StudioKAT/SRSH/v1.0/Images/SRSH_v1.0_Back.jpg

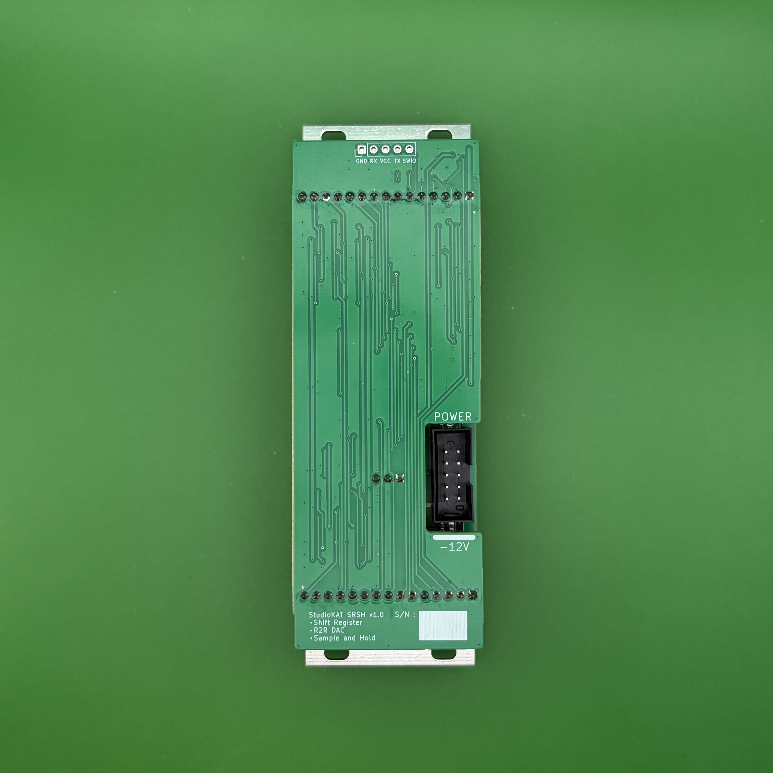
v1.0/Images/SRSH_v1.0_Back.jpg
