StudioKAT/SRSH/v1.0/Images/SRSH_v1.0_Side.jpg

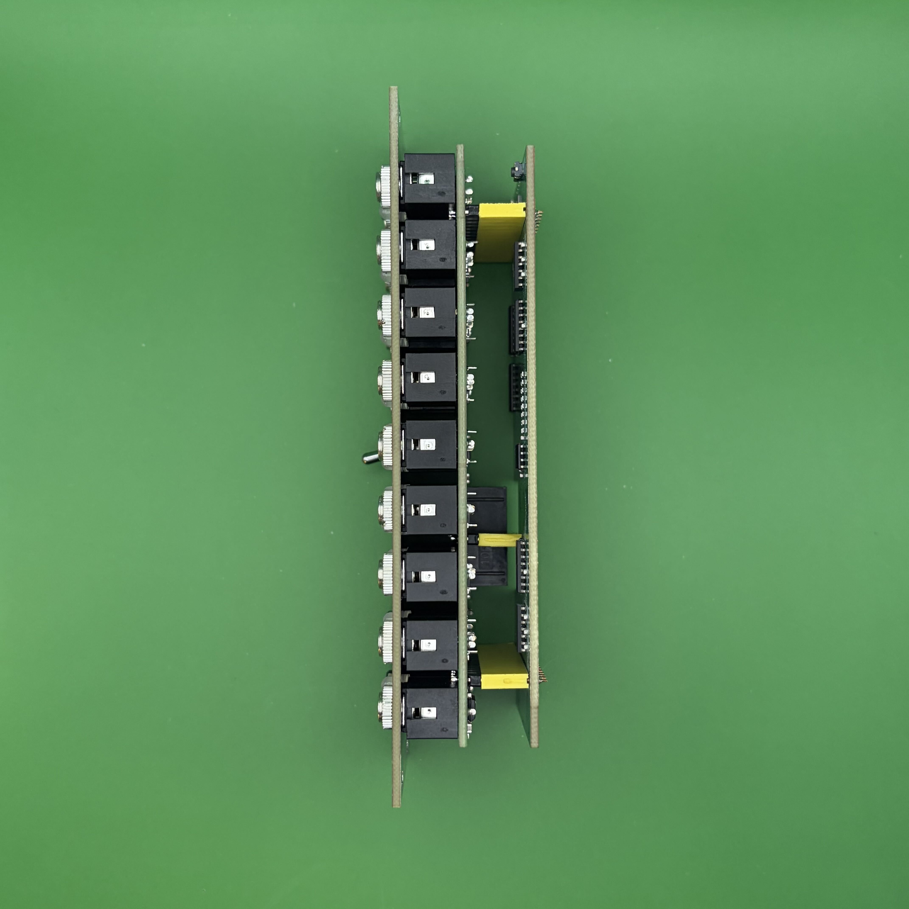
v1.0/Images/SRSH_v1.0_Side.jpg
