StudioKAT/SRSH/v1.0/Gerber_for_JLCPCB/Main_A/bom.csv

Designator | Footprint | Quantity | Value | LCSC Part #
C12, C13, C20, C21, C26, C27, C5, C6 | 0603 | 8 | 100nF | C14663
C25 | 0603 | 1 | 330nF | C1615
C28 | 0603 | 1 | 1uF | C15849
C29 | 0603 | 1 | 10pF | C1634
C3, C4 | 0805 | 2 | 22uF | C45783
D1, D2 | D_SOD-323 | 2 | 1N5819WS | C191023
D10, D11, D12, D13, D14, D15, D16, D8, D9 | LED_D3.0mm_2hp | 9 | LED
D17, D18, D19, D20, D21, D22, D23, D24 | LED_D3.0mm_2hp | 8 | LED_Dual_Bidirectional
D3, D4, D5, D6 | D_SOD-323 | 4 | 1N4148WS | C2128
J1 | BoxHeader_2x05_2.54mm_Europower | 1 | POWER
J10 | AudioJack_PJ301M-12 | 1 | RESET_IN
J11 | AudioJack_PJ301M-12 | 1 | DATA_IN
J12 | AudioJack_PJ301M-12 | 1 | XOR_IN
J13 | AudioJack_PJ301M-12 | 1 | R2R_OUT
J14 | AudioJack_PJ301M-12 | 1 | GATE_OUT_1
J15 | AudioJack_PJ301M-12 | 1 | GATE_OUT_2
J16 | AudioJack_PJ301M-12 | 1 | GATE_OUT_3
J17 | AudioJack_PJ301M-12 | 1 | GATE_OUT_4
J18 | AudioJack_PJ301M-12 | 1 | GATE_OUT_5
J19 | AudioJack_PJ301M-12 | 1 | GATE_OUT_6
J2, J5 | PinHeader_1x15_P2.54mm_Vertical | 2 | Conn_01x15_Pin
J20 | AudioJack_PJ301M-12 | 1 | GATE_OUT_7
J21 | AudioJack_PJ301M-12 | 1 | GATE_OUT_8
J22 | AudioJack_PJ301M-12 | 1 | SOURCE
J23 | AudioJack_PJ301M-12 | 1 | S&H_OUT_1
J24 | AudioJack_PJ301M-12 | 1 | S&H_OUT_2
J25 | AudioJack_PJ301M-12 | 1 | S&H_OUT_3
J26 | AudioJack_PJ301M-12 | 1 | S&H_OUT_4
J27 | AudioJack_PJ301M-12 | 1 | S&H_OUT_5
J28 | AudioJack_PJ301M-12 | 1 | S&H_OUT_6
J29 | AudioJack_PJ301M-12 | 1 | S&H_OUT_7
J30 | AudioJack_PJ301M-12 | 1 | S&H_OUT_8
J7 | PinHeader_1x03_P2.54mm_Vertical | 1 | Conn_01x03_Pin
J9 | AudioJack_PJ301M-12 | 1 | CLOCK_IN
Q1, Q2 | SOT-23 | 2 | MMBT3904 | C20526
Q10, Q11, Q12, Q13, Q14, Q15, Q4, Q5, Q6, Q7, Q8, Q9 | SOT-23 | 12 | BC847B | C20069135
R10, R11, R12, R33, R34, R35, R36, R37, R46, R47, R48, R49, R59, R60, R61, R62, R63, R64, R65, R66 | 0603 | 20 | 10k | C25804
R13, R43 | 0603 | 2 | 1M | C22935
R22 | 0603 | 1 | 2.2M | C22938
R31 | 0603 | 1 | 4.7k | C23162
R32, R39, R40, R41, R42 | 0603 | 5 | 100k | C25803
R44, R51, R52, R53, R54, R55, R56, R57, R58, R67, R68, R69, R70, R71, R72, R73, R74, R75, R77, R79, R81, R83, R85, R87, R89 | 0603 | 25 | 1k | C21190
R50 | 0603 | 1 | 100 | C22775
R76, R78, R80, R82, R84, R86, R88, R90 | 0603 | 8 | 2.2k | C4190
SW2 | ToggleSwitch_2MS1-T2-B4-M2-Q-E-S | 1 | SW_SPDT
SW3, SW4 | SW_PUSH_6mm_H13mm | 2 | SW_Push
U10 | SOT-89-3 | 1 | 78L05G-AB3-R | C71136
U3 | SOIC-8_3.9x4.9mm_P1.27mm | 1 | TL072CDT | C6961
