StudioKAT/SRSH/v1.0/Gerber_for_JLCPCB/Main_B/bom.csv

Designator | Footprint | Quantity | Value | LCSC Part #
C1, C10, C11, C14, C15, C16, C17, C18, C19, C2, C22, C23, C24, C7, C8, C9 | 0603 | 16 | 100nF | C14663
C30, C31, C32, C33, C34, C35, C36, C37 | 0603 | 8 | 10nF | C57112
D7 | D_SOD-323 | 1 | 1N4148WS | C2128
J3, J6 | PinSocket_1x15_P2.54mm_Vertical | 2 | Conn_01x15_Socket
J4 | PinHeader_1x05_P2.54mm_Vertical | 1 | EXT_Pinouts
J8 | PinSocket_1x03_P2.54mm_Vertical | 1 | Conn_01x03_Socket
Q3 | SOT-23 | 1 | BC847B | C20069135
R1, R2, R3, R4, R7 | 0603 | 5 | 100 | C22775
R14, R15, R16, R17, R18, R19, R20, R21, R30 | 0603 | 9 | 30k | C22984
R23, R24, R25, R26, R27, R28, R29 | 0603 | 7 | 15k | C22809
R38, R5, R6 | 0603 | 3 | 10k | C25804
R45, R8, R9 | 0603 | 3 | 1k | C21190
SW1 | SW_Push_TS-1088-AR02016 | 1 | TS-1088-AR02016 | C720477
U1, U2 | SOIC-14_3.9x8.7mm_P1.27mm | 2 | TL074IDR | C6964
U4 | SOIC-8_3.9x4.9mm_P1.27mm | 1 | TL072CDT | C6961
U5 | QFN-20-1EP_3x3mm_P0.4mm_EP1.65x1.65mm | 1 | CH32V003F4U6 | C5299908
U6, U7 | SOIC-16_3.9x9.9mm_P1.27mm | 2 | 74HC595D | C5947
U8, U9 | SOIC-16_3.9x9.9mm_P1.27mm | 2 | DG411DY-T1-E3 | C17218
