StudioKAT/SRSH/v1.0/Schematics/SRSH_v1.0_schematics.pdf

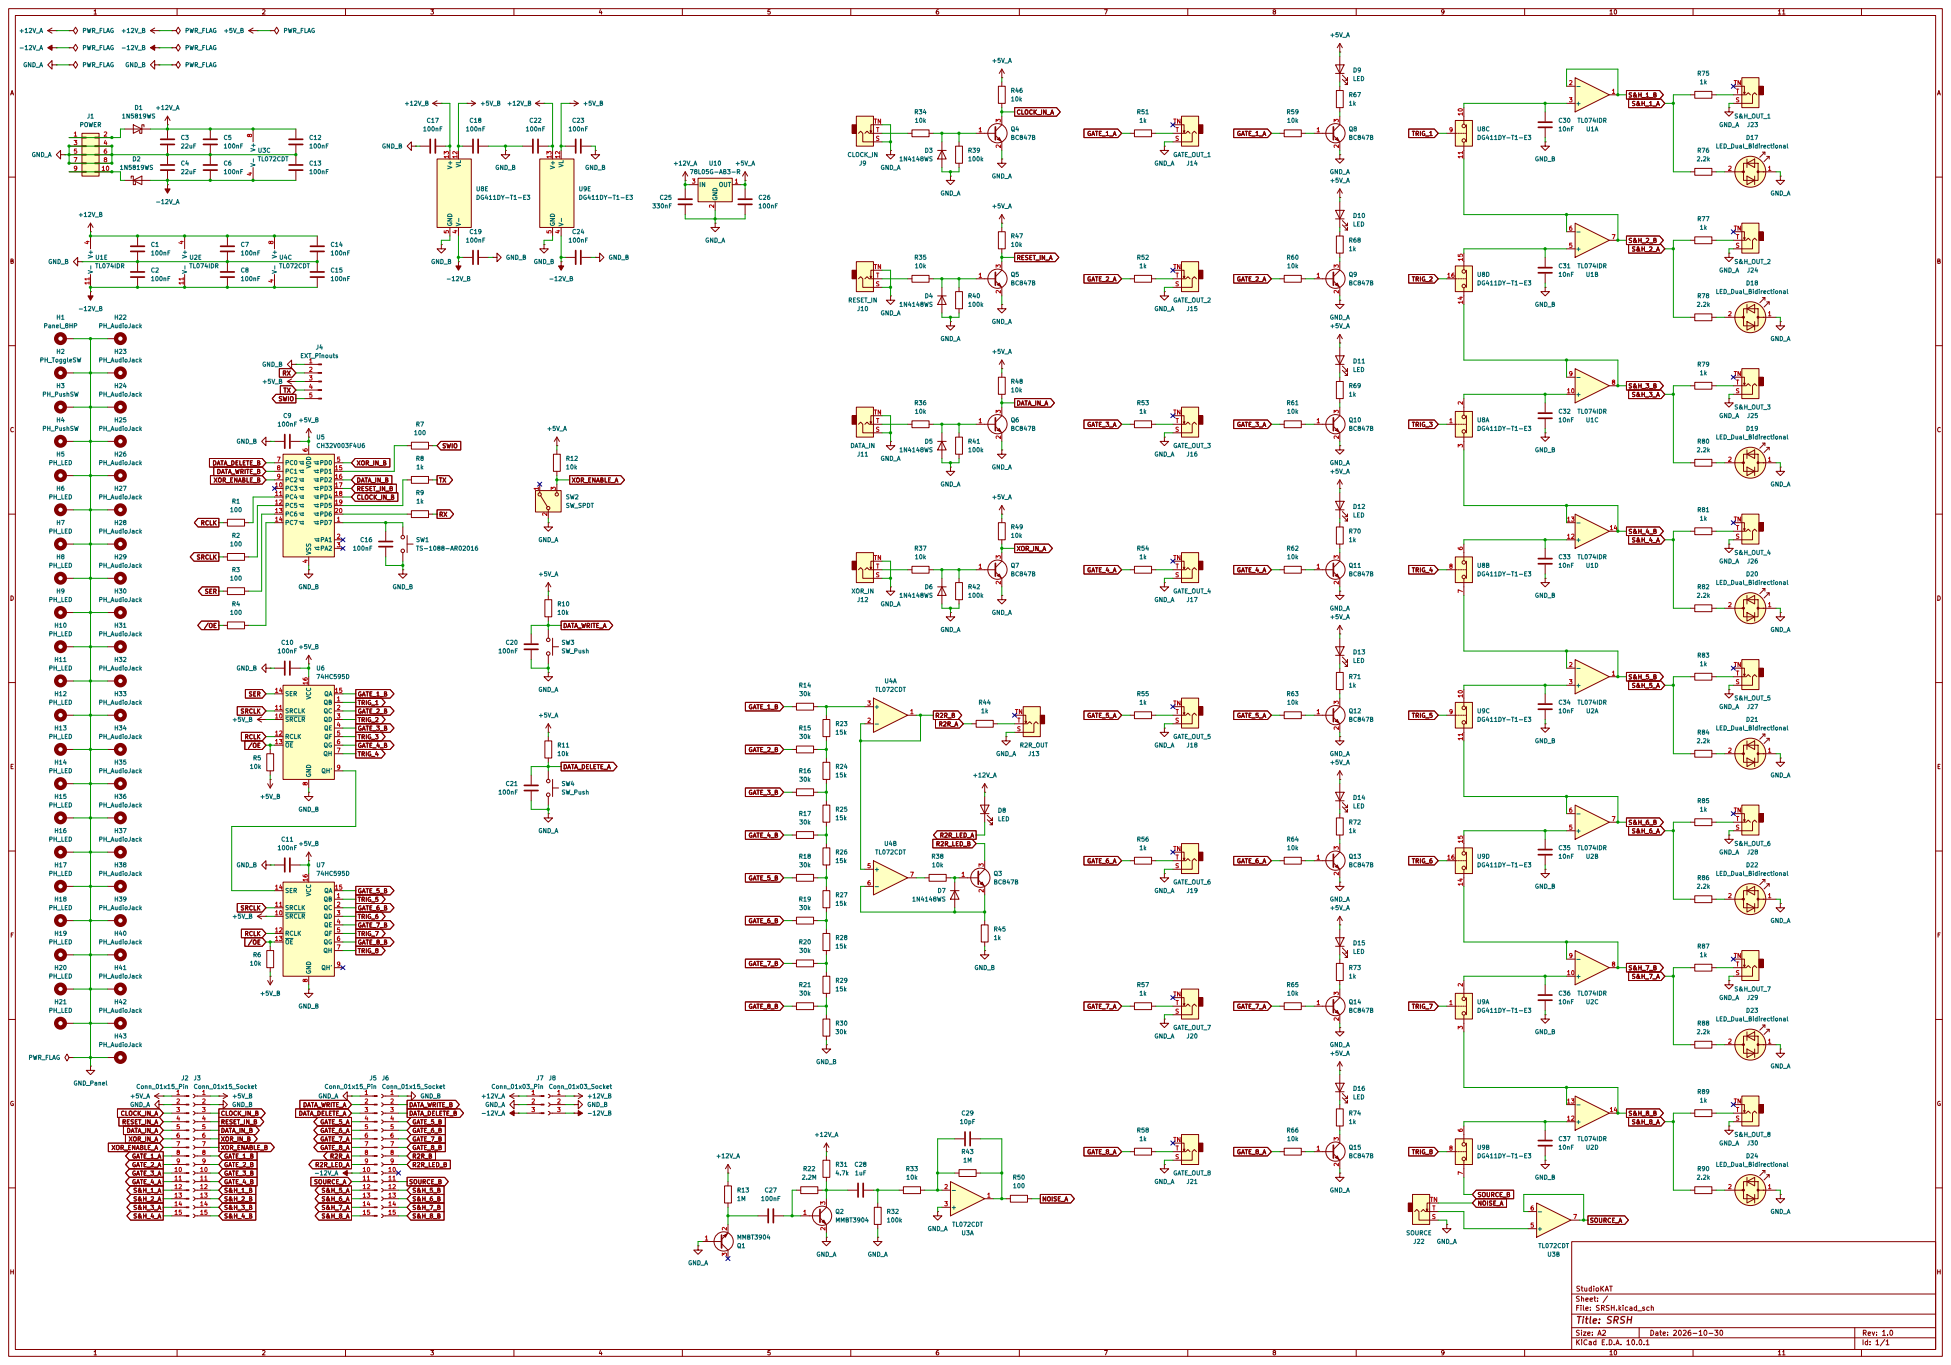
[picture p5: page 1]
