StudioKAT/SRSH/v1.0/KiCAD/SRSH_v1.0/SRSH_v1.0.kicad_pcb

## KiCad design v1.0/KiCAD/SRSH_v1.0/SRSH_v1.0.kicad_pcb (2026-10-30)

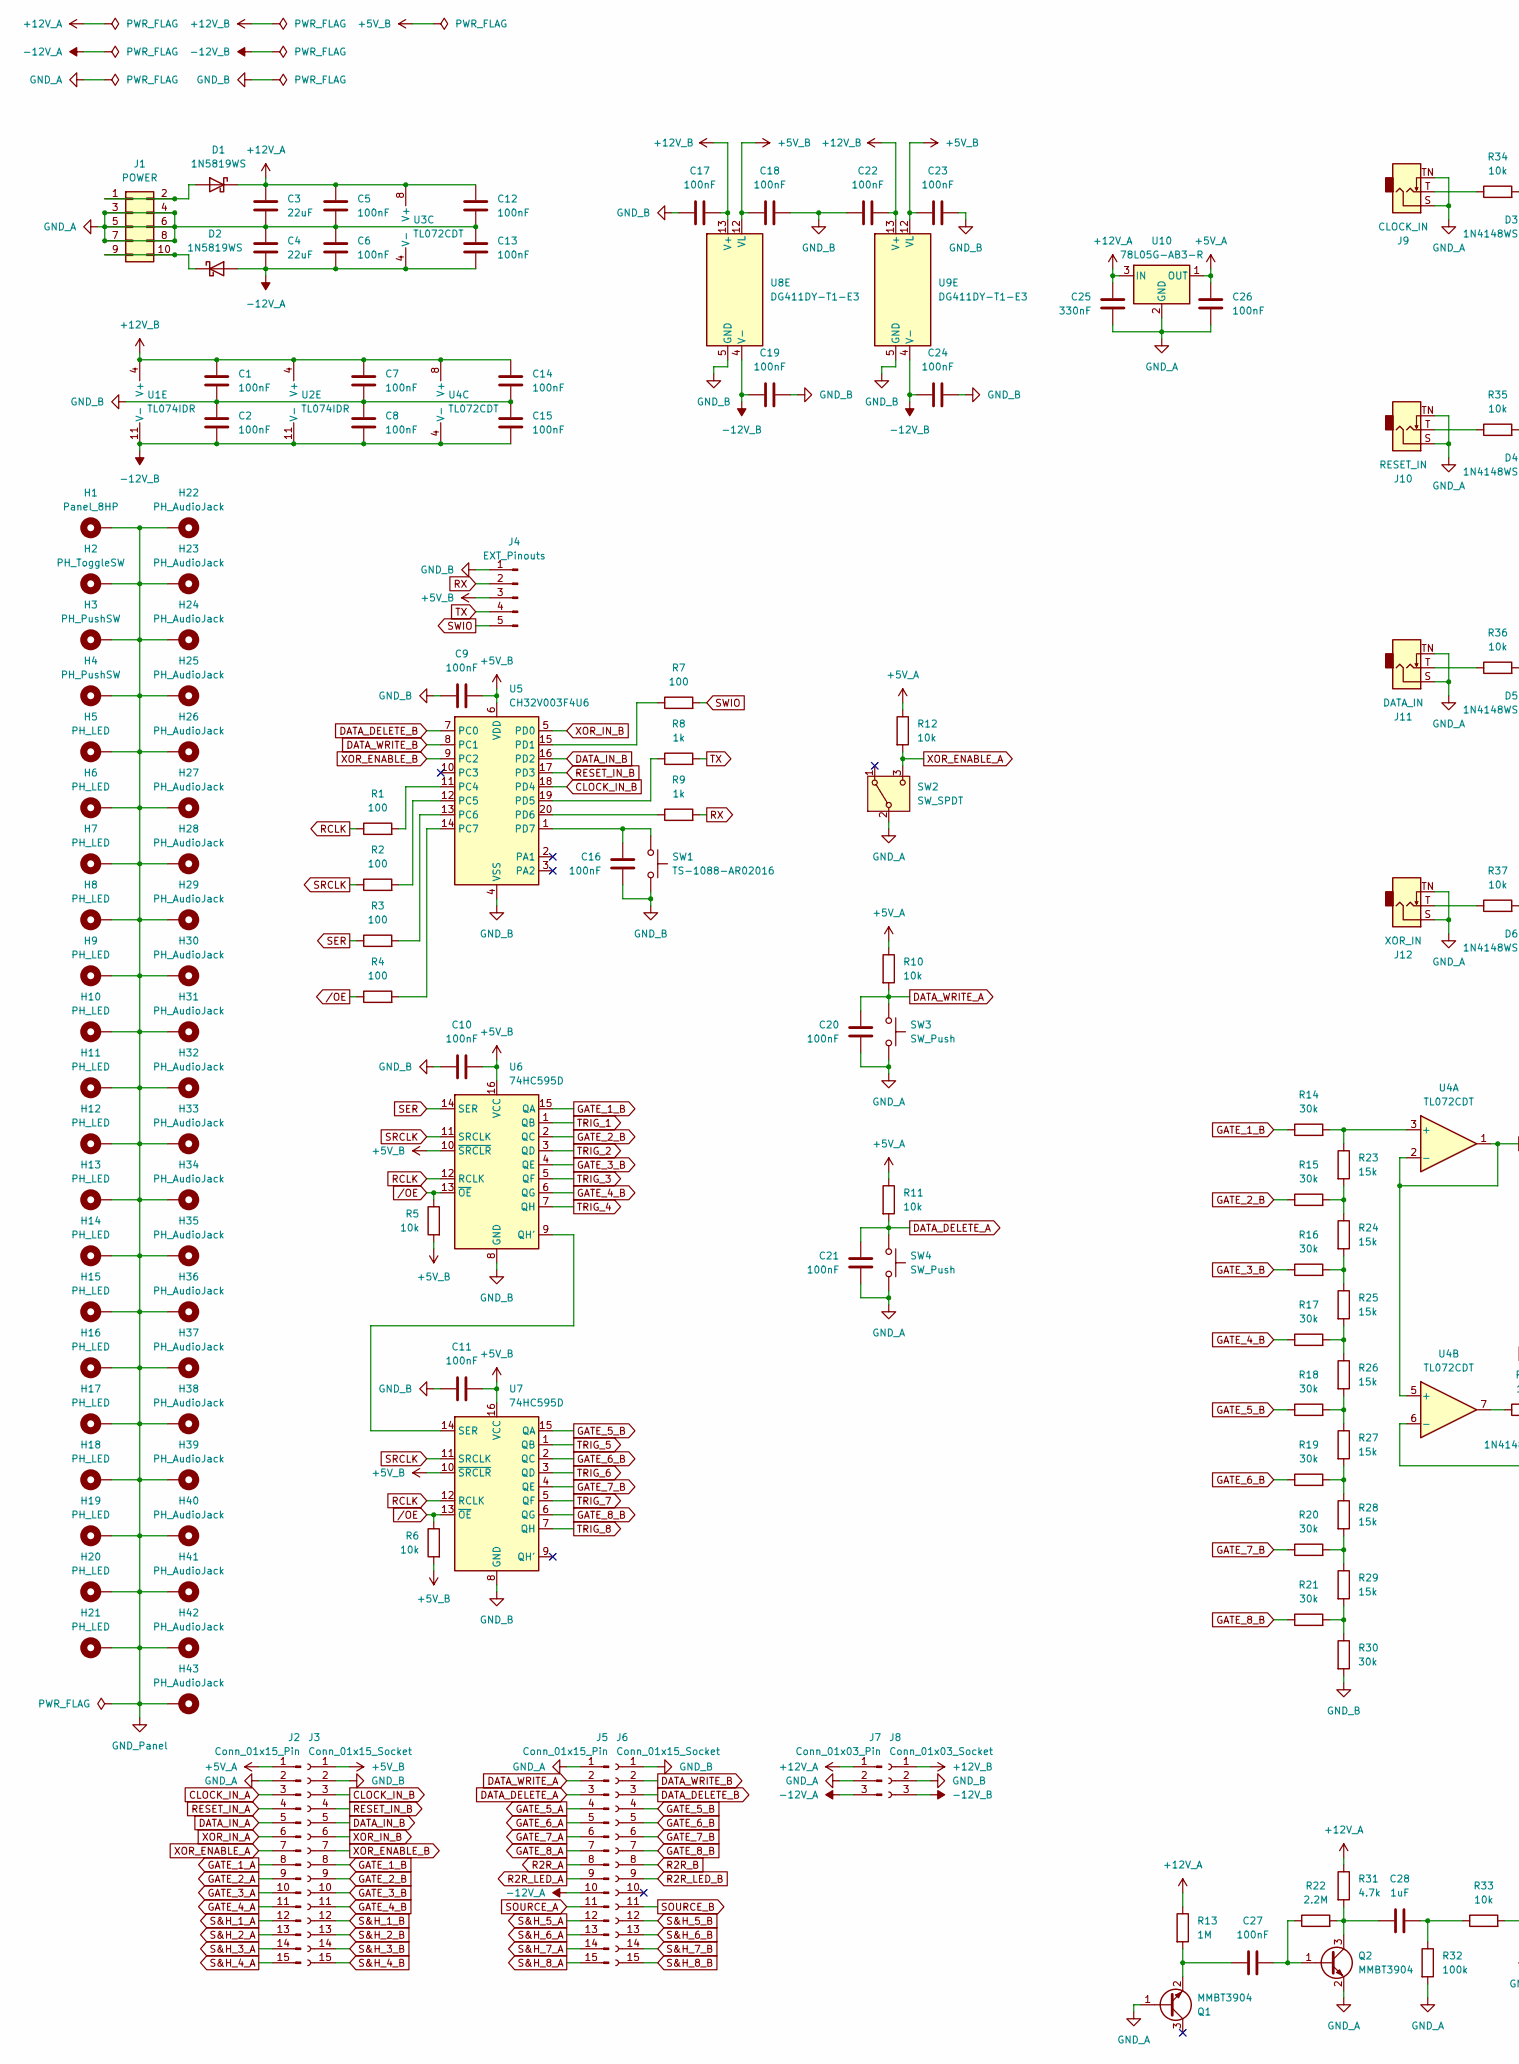
[picture p6: schematic SRSH_v1.0.kicad_sch, SRSH, part in row 1, column 1]

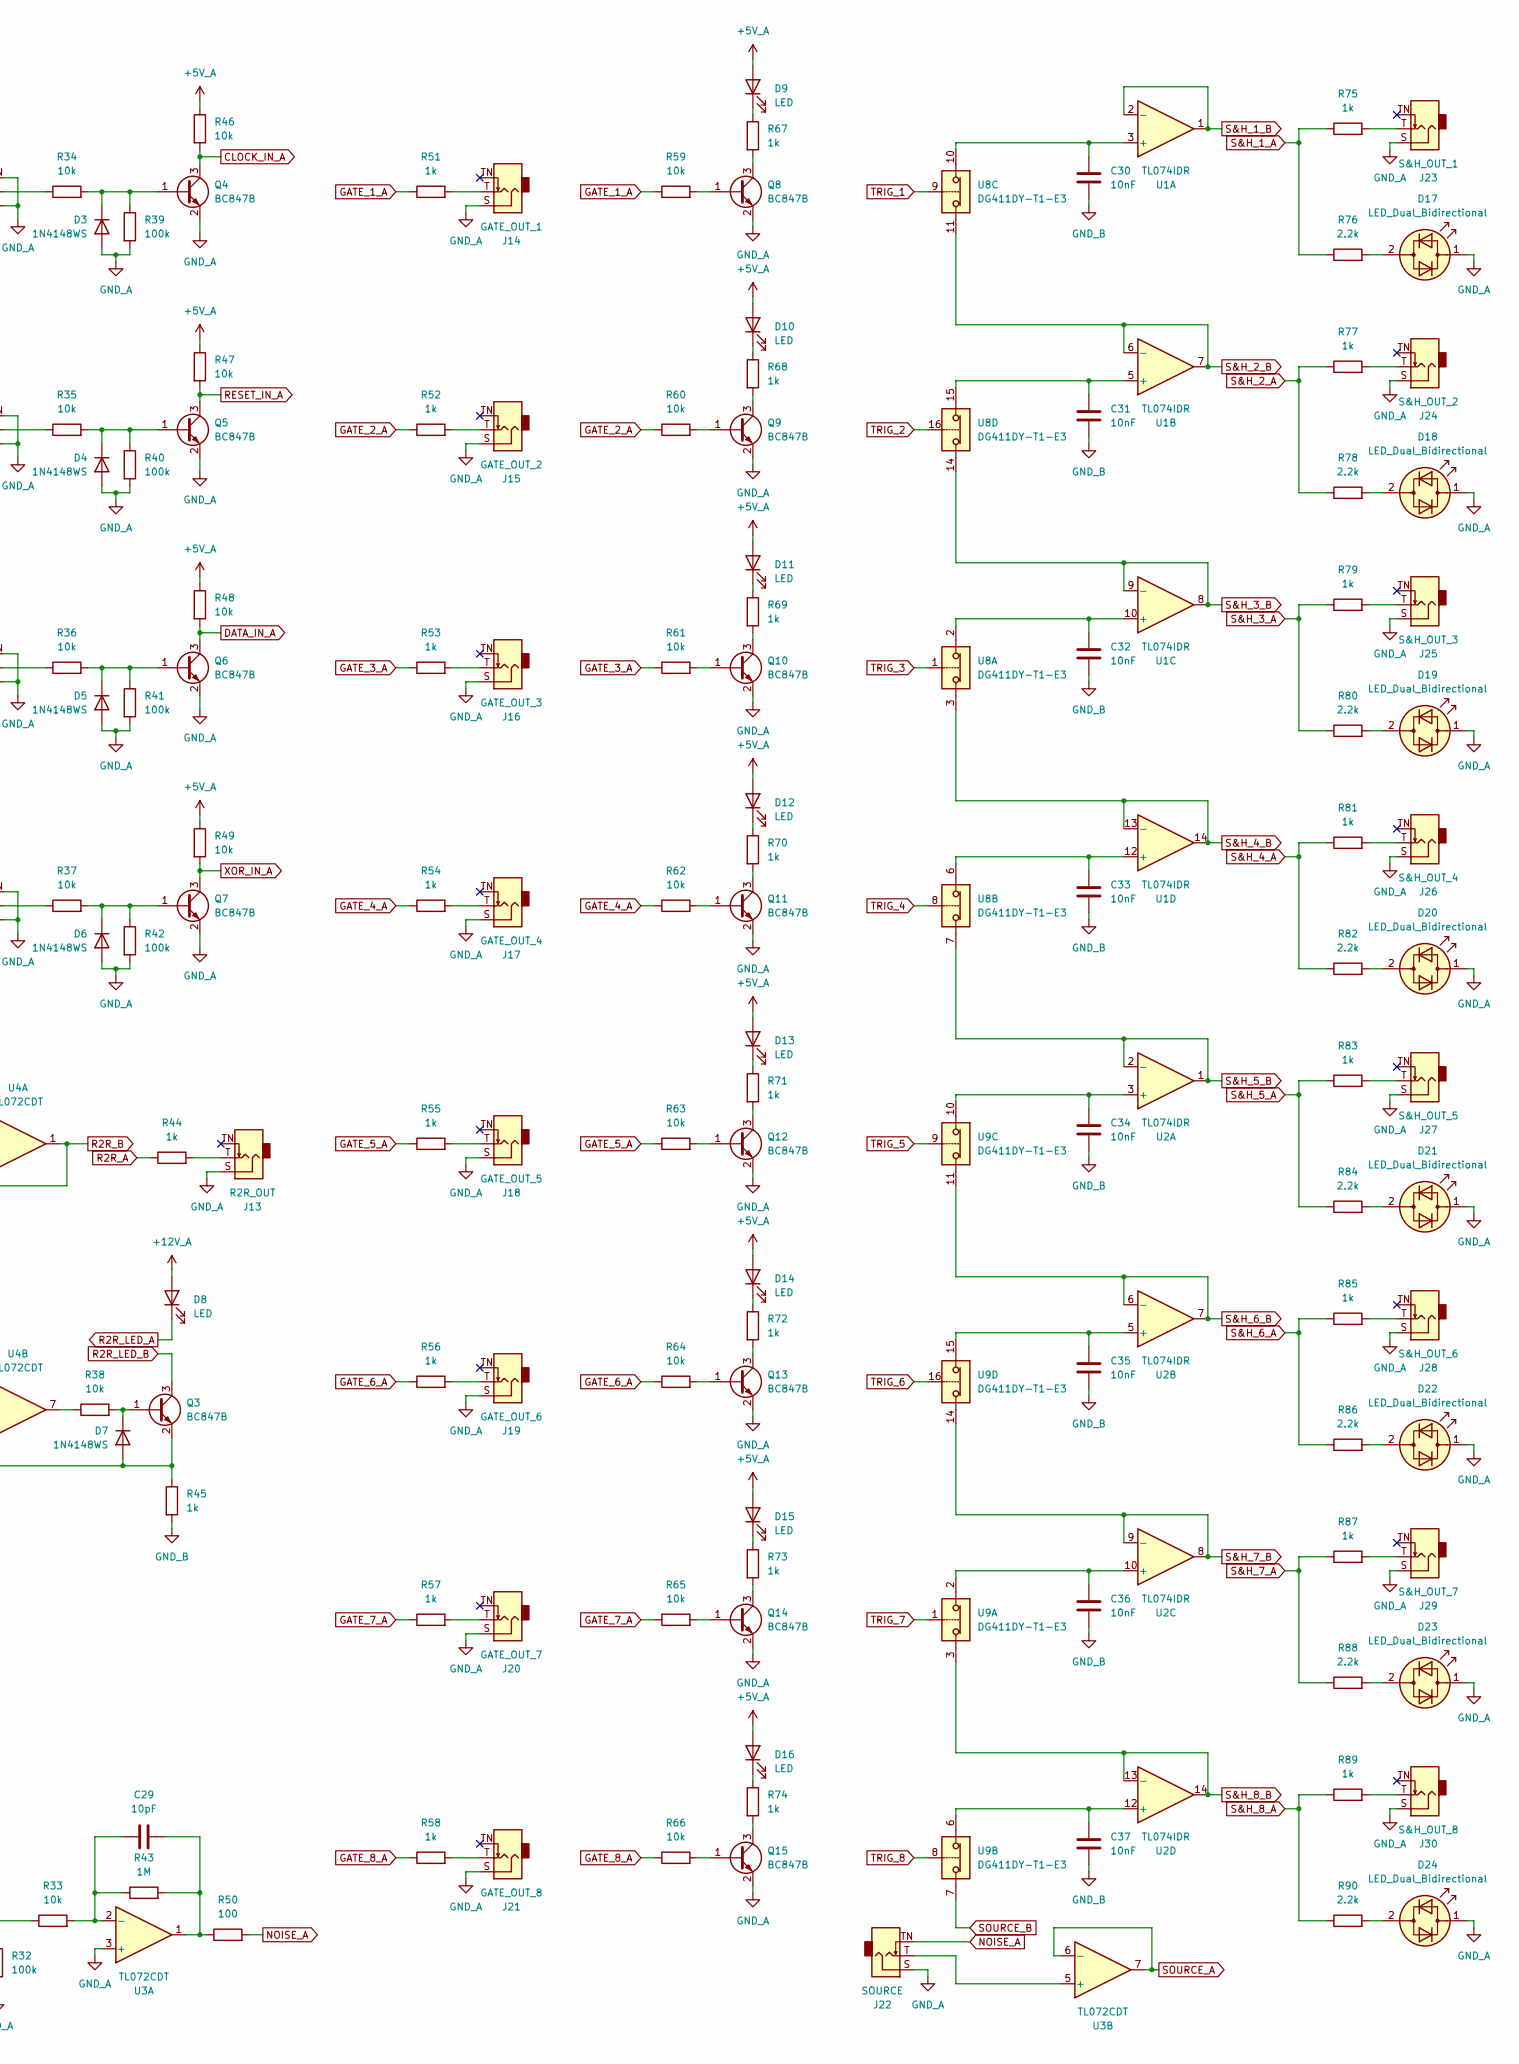
[picture p7: schematic SRSH_v1.0.kicad_sch, SRSH, part in row 1, column 2]

Parts:
C1, C2, C5, C6, C7, C8, C9, C10, C11, C12, C13, C14, C15, C16, C17, C18, C19, C20, C21, C22, C23, C24, C26, C27: 100nF; C_0603_1608Metric; Voltage 50V; Tolerance ±10%; MFR Part CC0603KRX7R9BB104; JLC Type Basic
C3, C4: 22uF; C_0805_2012Metric; Voltage 25V; Tolerance ±20%; MFR Part CL21A226MAQNNNE; JLC Type Basic
C25: 330nF; C_0603_1608Metric; Voltage 25V; Tolerance ±10%; MFR Part 0603B334K250NT; LCSC C1615
C28: 1uF; C_0603_1608Metric; Voltage 50V; Tolerance ±10%; MFR Part CL10A105KB8NNNC; JLC Type Basic
C29: 10pF; C_0603_1608Metric; Voltage 50V; Tolerance ±5%; MFR Part CL10C100JB8NNNC; JLC Type Basic
C30, C31, C32, C33, C34, C35, C36, C37: 10nF; C_0603_1608Metric; Voltage 50V; Tolerance ±10%; MFR Part 0603B103K500NT; JLC Type Basic
D1, D2: 1N5819WS; D_SOD-323; MFR Part 1N5819WS; JLC Type Basic
D3, D4, D5, D6, D7: 1N4148WS; D_SOD-323; MFR Part 1N4148WS; JLC Type Basic
D8, D9, D10, D11, D12, D13, D14, D15, D16: LED; LED_D3.0mm_2hp
D17, D18, D19, D20, D21, D22, D23, D24: LED_Dual_Bidirectional; LED_D3.0mm_2hp
H1: Panel_8HP
H2: PH_ToggleSW; PH_ToggleSwitch_5.1mm_Pad
H3, H4: PH_PushSW; PH_TactileSwitch_5.5mm_Pad
H5, H6, H7, H8, H9, H10, H11, H12, H13, H14, H15, H16, H17, H18, H19, H20, H21: PH_LED; PH_LED_3.0mm_Pad
H22, H23, H24, H25, H26, H27, H28, H29, H30, H31, H32, H33, H34, H35, H36, H37, H38, H39, H40, H41, H42, H43: PH_AudioJack; PH_AudioJack_3.5mm_Pad
J1: POWER; BoxHeader_2x05_2.54mm_Europower
J2, J5: Conn_01x15_Pin; PinHeader_1x15_P2.54mm_Vertical
J3, J6: Conn_01x15_Socket; PinSocket_1x15_P2.54mm_Vertical
J4: EXT_Pinouts; PinHeader_1x05_P2.54mm_Vertical
J7: Conn_01x03_Pin; PinHeader_1x03_P2.54mm_Vertical
J8: Conn_01x03_Socket; PinSocket_1x03_P2.54mm_Vertical
J9: CLOCK_IN; AudioJack_PJ301M-12
J10: RESET_IN; AudioJack_PJ301M-12
J11: DATA_IN; AudioJack_PJ301M-12
J12: XOR_IN; AudioJack_PJ301M-12
J13: R2R_OUT; AudioJack_PJ301M-12
J14: GATE_OUT_1; AudioJack_PJ301M-12
J15: GATE_OUT_2; AudioJack_PJ301M-12
J16: GATE_OUT_3; AudioJack_PJ301M-12
J17: GATE_OUT_4; AudioJack_PJ301M-12
J18: GATE_OUT_5; AudioJack_PJ301M-12
J19: GATE_OUT_6; AudioJack_PJ301M-12
J20: GATE_OUT_7; AudioJack_PJ301M-12
J21: GATE_OUT_8; AudioJack_PJ301M-12
J22: SOURCE; AudioJack_PJ301M-12
J23: S&H_OUT_1; AudioJack_PJ301M-12
J24: S&H_OUT_2; AudioJack_PJ301M-12
J25: S&H_OUT_3; AudioJack_PJ301M-12
J26: S&H_OUT_4; AudioJack_PJ301M-12
J27: S&H_OUT_5; AudioJack_PJ301M-12
J28: S&H_OUT_6; AudioJack_PJ301M-12
J29: S&H_OUT_7; AudioJack_PJ301M-12
J30: S&H_OUT_8; AudioJack_PJ301M-12
Q1, Q2: MMBT3904; SOT-23; MFR Part MMBT3904(RANGE:100-300); JLC Type Basic
Q3, Q4, Q5, Q6, Q7, Q8, Q9, Q10, Q11, Q12, Q13, Q14, Q15: BC847B; SOT-23; MFR Part BC847B; LCSC C20069135
R1, R2, R3, R4, R7, R50: 100; R_0603_1608Metric; Tolerance ±1%; MFR Part 0603WAF1000T5E; JLC Type Basic
R5, R6, R10, R11, R12, R33, R34, R35, R36, R37, R38, R46, R47, R48, R49, R59, R60, R61, R62, R63, R64, R65, R66: 10k; R_0603_1608Metric; Tolerance ±1%; MFR Part 0603WAF1002T5E; JLC Type Basic
R8, R9, R44, R45, R51, R52, R53, R54, R55, R56, R57, R58, R67, R68, R69, R70, R71, R72, R73, R74, R75, R77, R79, R81, R83, R85, R87, R89: 1k; R_0603_1608Metric; Tolerance ±1%; MFR Part 0603WAF1001T5E; JLC Type Basic
R13, R43: 1M; R_0603_1608Metric; Tolerance ±1%; MFR Part 0603WAF1004T5E; JLC Type Basic
R14, R15, R16, R17, R18, R19, R20, R21, R30: 30k; R_0603_1608Metric; Tolerance ±1%; MFR Part 0603WAF3002T5E; JLC Type Basic
R22: 2.2M; R_0603_1608Metric; Tolerance ±1%; MFR Part 0603WAF2204T5E; LCSC C22938
R23, R24, R25, R26, R27, R28, R29: 15k; R_0603_1608Metric; Tolerance ±1%; MFR Part 0603WAF1502T5E; JLC Type Basic
R31: 4.7k; R_0603_1608Metric; Tolerance ±1%; MFR Part 0603WAF4701T5E; JLC Type Basic
R32, R39, R40, R41, R42: 100k; R_0603_1608Metric; Tolerance ±1%; MFR Part 0603WAF1003T5E; JLC Type Basic
R76, R78, R80, R82, R84, R86, R88, R90: 2.2k; R_0603_1608Metric; Tolerance ±1%; MFR Part 0603WAF2201T5E; JLC Type Basic
SW1: TS-1088-AR02016; SW_Push_TS-1088-AR02016; MFR Part TS-1088-AR02016; JLC Type Basic
SW2: SW_SPDT; ToggleSwitch_2MS1-T2-B4-M2-Q-E-S
SW3, SW4: SW_Push; SW_PUSH_6mm_H13mm
U1, U2: TL074IDR; SOIC-14_3.9x8.7mm_P1.27mm; LCSC C6964
U3, U4: TL072CDT; SOIC-8_3.9x4.9mm_P1.27mm; MFR Part TL072CDT; JLC Type Basic
U5: CH32V003F4U6; QFN-20-1EP_3x3mm_P0.4mm_EP1.65x1.65mm; LCSC C5299908
U6, U7: 74HC595D; SOIC-16_3.9x9.9mm_P1.27mm; MFR Part 74HC595D,118; JLC Type Basic
U8, U9: DG411DY-T1-E3; SOIC-16_3.9x9.9mm_P1.27mm; LCSC C17218
U10: 78L05G-AB3-R; SOT-89-3; MFR Part 78L05G-AB3-R; JLC Type Basic

Connections:
+5V_A: C26.1, D9.2 (A), D10.2 (A), D11.2 (A), D12.2 (A), D13.2 (A), D14.2 (A), D15.2 (A), D16.2 (A), J2.1, R10.1, R11.1, R12.1, R46.1, R47.1, R48.1, R49.1, U10.1 (OUT)
+5V_B: C9.2, C10.2, C11.2, C18.1, C23.1, J3.1, J4.3, R5.2, R6.2, U5.6 (VDD), U6.10 (~SRCLR), U6.16 (VCC), U7.10 (~SRCLR), U7.16 (VCC), U8.12 (VL), U9.12 (VL)
+12V_A: C3.1, C5.1, C12.1, C25.1, D1.1 (K), D8.2 (A), J7.1, R13.1, R31.1, U3.8 (V+), U10.3 (IN)
+12V_B: C1.1, C7.1, C14.1, C17.2, C22.2, J8.1, U1.4 (V+), U2.4 (V+), U4.8 (V+), U8.13 (V+), U9.13 (V+)
-12V_A: C4.2, C6.2, C13.2, D2.2 (A), J5.10, J7.3, U3.4 (V-)
-12V_B: C2.2, C8.2, C15.2, C19.1, C24.1, J8.3, U1.11 (V-), U2.11 (V-), U4.4 (V-), U8.4 (V-), U9.4 (V-)
CLOCK_IN_A: J2.3, Q4.3 (C), R46.2
CLOCK_IN_B: J3.3, U5.18 (PD4)
DATA_DELETE_A: C21.1, J5.3, R11.2, SW4.1
DATA_DELETE_B: J6.3, U5.7 (PC0)
DATA_IN_A: J2.5, Q6.3 (C), R48.2
DATA_IN_B: J3.5, U5.16 (PD2)
DATA_WRITE_A: C20.1, J5.2, R10.2, SW3.1
DATA_WRITE_B: J6.2, U5.8 (PC1)
GATE_1_A: J2.8, R51.1, R59.1
GATE_1_B: J3.8, R14.1, U6.15 (QA)
GATE_2_A: J2.9, R52.1, R60.1
GATE_2_B: J3.9, R15.1, U6.2 (QC)
GATE_3_A: J2.10, R53.1, R61.1
GATE_3_B: J3.10, R16.1, U6.4 (QE)
GATE_4_A: J2.11, R54.1, R62.1
GATE_4_B: J3.11, R17.1, U6.6 (QG)
GATE_5_A: J5.4, R55.1, R63.1
GATE_5_B: J6.4, R18.1, U7.15 (QA)
GATE_6_A: J5.5, R56.1, R64.1
GATE_6_B: J6.5, R19.1, U7.2 (QC)
GATE_7_A: J5.6, R57.1, R65.1
GATE_7_B: J6.6, R20.1, U7.4 (QE)
GATE_8_A: J5.7, R58.1, R66.1
GATE_8_B: J6.7, R21.1, U7.6 (QG)
GND_A: C3.2, C4.1, C5.2, C6.1, C12.2, C13.1, C20.2, C21.2, C25.2, C26.2, D3.2 (A), D4.2 (A), D5.2 (A), D6.2 (A), D17.1 (KA), D18.1 (KA), D19.1 (KA), D20.1 (KA), D21.1 (KA), D22.1 (KA), D23.1 (KA), D24.1 (KA), J1.3, J1.4, J1.5, J1.6, J1.7, J1.8, J2.2, J5.1, J7.2, J9.S, J9.TN, J10.S, J10.TN, J11.S, J11.TN, J12.S, J12.TN, J13.S, J14.S, J15.S, J16.S, J17.S, J18.S, J19.S, J20.S, J21.S, J22.S, J23.S, J24.S, J25.S, J26.S, J27.S, J28.S, J29.S, J30.S, Q1.1 (B), Q2.2 (E), Q4.2 (E), Q5.2 (E), Q6.2 (E), Q7.2 (E), Q8.2 (E), Q9.2 (E), Q10.2 (E), Q11.2 (E), Q12.2 (E), Q13.2 (E), Q14.2 (E), Q15.2 (E), R32.2, R39.2, R40.2, R41.2, R42.2, SW2.2 (B), SW3.2, SW4.2, U3.3 (+), U10.2 (GND)
GND_B: C1.2, C2.1, C7.2, C8.1, C9.1, C10.1, C11.1, C14.2, C15.1, C16.2, C17.1, C18.2, C19.2, C22.1, C23.2, C24.2, C30.2, C31.2, C32.2, C33.2, C34.2, C35.2, C36.2, C37.2, J3.2, J4.1, J6.1, J8.2, R30.2, R45.2, SW1.2, U5.4 (VSS), U5.21 (VSS), U6.8 (GND), U7.8 (GND), U8.5 (GND), U9.5 (GND)
GND_Panel: H1.1 (1_1), H2.1 (1_1), H3.1 (1_1), H4.1 (1_1), H5.1 (1_1), H6.1 (1_1), H7.1 (1_1), H8.1 (1_1), H9.1 (1_1), H10.1 (1_1), H11.1 (1_1), H12.1 (1_1), H13.1 (1_1), H14.1 (1_1), H15.1 (1_1), H16.1 (1_1), H17.1 (1_1), H18.1 (1_1), H19.1 (1_1), H20.1 (1_1), H21.1 (1_1), H22.1 (1_1), H23.1 (1_1), H24.1 (1_1), H25.1 (1_1), H26.1 (1_1), H27.1 (1_1), H28.1 (1_1), H29.1 (1_1), H30.1 (1_1), H31.1 (1_1), H32.1 (1_1), H33.1 (1_1), H34.1 (1_1), H35.1 (1_1), H36.1 (1_1), H37.1 (1_1), H38.1 (1_1), H39.1 (1_1), H40.1 (1_1), H41.1 (1_1), H42.1 (1_1), H43.1 (1_1)
NOISE_A: J22.TN, R50.2
unnamed: C28.2, R32.1, R33.1
unnamed: C29.2, R43.2, R50.1, U3.1
unnamed: D1.2 (A), J1.1, J1.2
unnamed: D2.1 (K), J1.9, J1.10
unnamed: D3.1 (K), Q4.1 (B), R34.2, R39.1
unnamed: D4.1 (K), Q5.1 (B), R35.2, R40.1
unnamed: D5.1 (K), Q6.1 (B), R36.2, R41.1
unnamed: D6.1 (K), Q7.1 (B), R37.2, R42.1
unnamed: D7.2 (A), Q3.2 (E), R45.1, U4.6 (-)
unnamed: D7.1 (K), Q3.1 (B), R38.2
unnamed: D9.1 (K), R67.1
unnamed: D10.1 (K), R68.1
unnamed: D11.1 (K), R69.1
unnamed: D12.1 (K), R70.1
unnamed: D13.1 (K), R71.1
unnamed: D14.1 (K), R72.1
unnamed: D15.1 (K), R73.1
unnamed: D16.1 (K), R74.1
unnamed: D17.2 (AK), R76.2
unnamed: D18.2 (AK), R78.2
unnamed: D19.2 (AK), R80.2
unnamed: D20.2 (AK), R82.2
unnamed: D21.2 (AK), R84.2
unnamed: D22.2 (AK), R86.2
unnamed: D23.2 (AK), R88.2
unnamed: D24.2 (AK), R90.2
unnamed: J9.T, R34.1
unnamed: J10.T, R35.1
unnamed: J11.T, R36.1
unnamed: J12.T, R37.1
unnamed: J13.T, R44.2
unnamed: J14.T, R51.2
unnamed: J15.T, R52.2
unnamed: J16.T, R53.2
unnamed: J17.T, R54.2
unnamed: J18.T, R55.2
unnamed: J19.T, R56.2
unnamed: J20.T, R57.2
unnamed: J21.T, R58.2
unnamed: J23.T, R75.2
unnamed: J24.T, R77.2
unnamed: J25.T, R79.2
unnamed: J26.T, R81.2
unnamed: J27.T, R83.2
unnamed: J28.T, R85.2
unnamed: J29.T, R87.2
unnamed: J30.T, R89.2
unnamed: C27.1, Q1.2 (E), R13.2
unnamed: C27.2, Q2.1 (B), R22.1
unnamed: C28.1, Q2.3 (C), R22.2, R31.2
unnamed: Q8.1 (B), R59.2
unnamed: Q8.3 (C), R67.2
unnamed: Q9.1 (B), R60.2
unnamed: Q9.3 (C), R68.2
unnamed: Q10.1 (B), R61.2
unnamed: Q10.3 (C), R69.2
unnamed: Q11.1 (B), R62.2
unnamed: Q11.3 (C), R70.2
unnamed: Q12.1 (B), R63.2
unnamed: Q12.3 (C), R71.2
unnamed: Q13.1 (B), R64.2
unnamed: Q13.3 (C), R72.2
unnamed: Q14.1 (B), R65.2
unnamed: Q14.3 (C), R73.2
unnamed: Q15.1 (B), R66.2
unnamed: Q15.3 (C), R74.2
unnamed: R15.2, R23.2, R24.1
unnamed: R16.2, R24.2, R25.1
unnamed: R17.2, R25.2, R26.1
unnamed: R18.2, R26.2, R27.1
unnamed: R19.2, R27.2, R28.1
unnamed: R20.2, R28.2, R29.1
unnamed: R21.2, R29.2, R30.1
unnamed: R38.1, U4.7
unnamed: C30.1, U1.3 (+), U8.10
unnamed: C31.1, U1.5 (+), U8.15
unnamed: C32.1, U1.10 (+), U8.2
unnamed: C33.1, U1.12 (+), U8.6
unnamed: C34.1, U2.3 (+), U9.10
unnamed: C35.1, U2.5 (+), U9.15
unnamed: C36.1, U2.10 (+), U9.2
unnamed: C37.1, U2.12 (+), U9.6
unnamed: C29.1, R33.2, R43.1, U3.2 (-)
unnamed: J22.T, U3.5 (+)
unnamed: R14.2, R23.1, U4.3 (+)
unnamed: R1.2, U5.11 (PC4)
unnamed: R2.2, U5.12 (PC5)
unnamed: R3.2, U5.13 (PC6)
unnamed: R4.2, U5.14 (PC7)
unnamed: R7.1, U5.15 (PD1)
unnamed: R8.1, U5.19 (PD5)
unnamed: R9.1, U5.20 (PD6)
unnamed: C16.1, SW1.1, U5.1 (PD7)
unnamed: U6.9 (QH'), U7.14 (SER)
R2R_A: J5.8, R44.1
R2R_B: J6.8, U4.1, U4.2 (-), U4.5 (+)
R2R_LED_A: D8.1 (K), J5.9
R2R_LED_B: J6.9, Q3.3 (C)
RCLK: R1.1, U6.12 (RCLK), U7.12 (RCLK)
RESET_IN_A: J2.4, Q5.3 (C), R47.2
RESET_IN_B: J3.4, U5.17 (PD3)
RX: J4.2, R9.2
S&H_1_A: J2.12, R75.1, R76.1
S&H_1_B: J3.12, U1.1, U1.2 (-)
S&H_2_A: J2.13, R77.1, R78.1
S&H_2_B: J3.13, U1.6 (-), U1.7, U8.11
S&H_3_A: J2.14, R79.1, R80.1
S&H_3_B: J3.14, U1.8, U1.9 (-), U8.14
S&H_4_A: J2.15, R81.1, R82.1
S&H_4_B: J3.15, U1.13 (-), U1.14, U8.3
S&H_5_A: J5.12, R83.1, R84.1
S&H_5_B: J6.12, U2.1, U2.2 (-), U8.7
S&H_6_A: J5.13, R85.1, R86.1
S&H_6_B: J6.13, U2.6 (-), U2.7, U9.11
S&H_7_A: J5.14, R87.1, R88.1
S&H_7_B: J6.14, U2.8, U2.9 (-), U9.14
S&H_8_A: J5.15, R89.1, R90.1
S&H_8_B: J6.15, U2.13 (-), U2.14, U9.3
SER: R3.1, U6.14 (SER)
SOURCE_A: J5.11, U3.6 (-), U3.7
SOURCE_B: J6.11, U9.7
SRCLK: R2.1, U6.11 (SRCLK), U7.11 (SRCLK)
SWIO: J4.5, R7.2
TRIG_1: U6.1 (QB), U8.9
TRIG_2: U6.3 (QD), U8.16
TRIG_3: U6.5 (QF), U8.1
TRIG_4: U6.7 (QH), U8.8
TRIG_5: U7.1 (QB), U9.9
TRIG_6: U7.3 (QD), U9.16
TRIG_7: U7.5 (QF), U9.1
TRIG_8: U7.7 (QH), U9.8
TX: J4.4, R8.2
XOR_ENABLE_A: J2.7, R12.2, SW2.3 (C)
XOR_ENABLE_B: J3.7, U5.9 (PC2)
XOR_IN_A: J2.6, Q7.3 (C), R49.2
XOR_IN_B: J3.6, U5.5 (PD0)
/OE: R4.1, R5.1, R6.1, U6.13 (~OE), U7.13 (~OE)

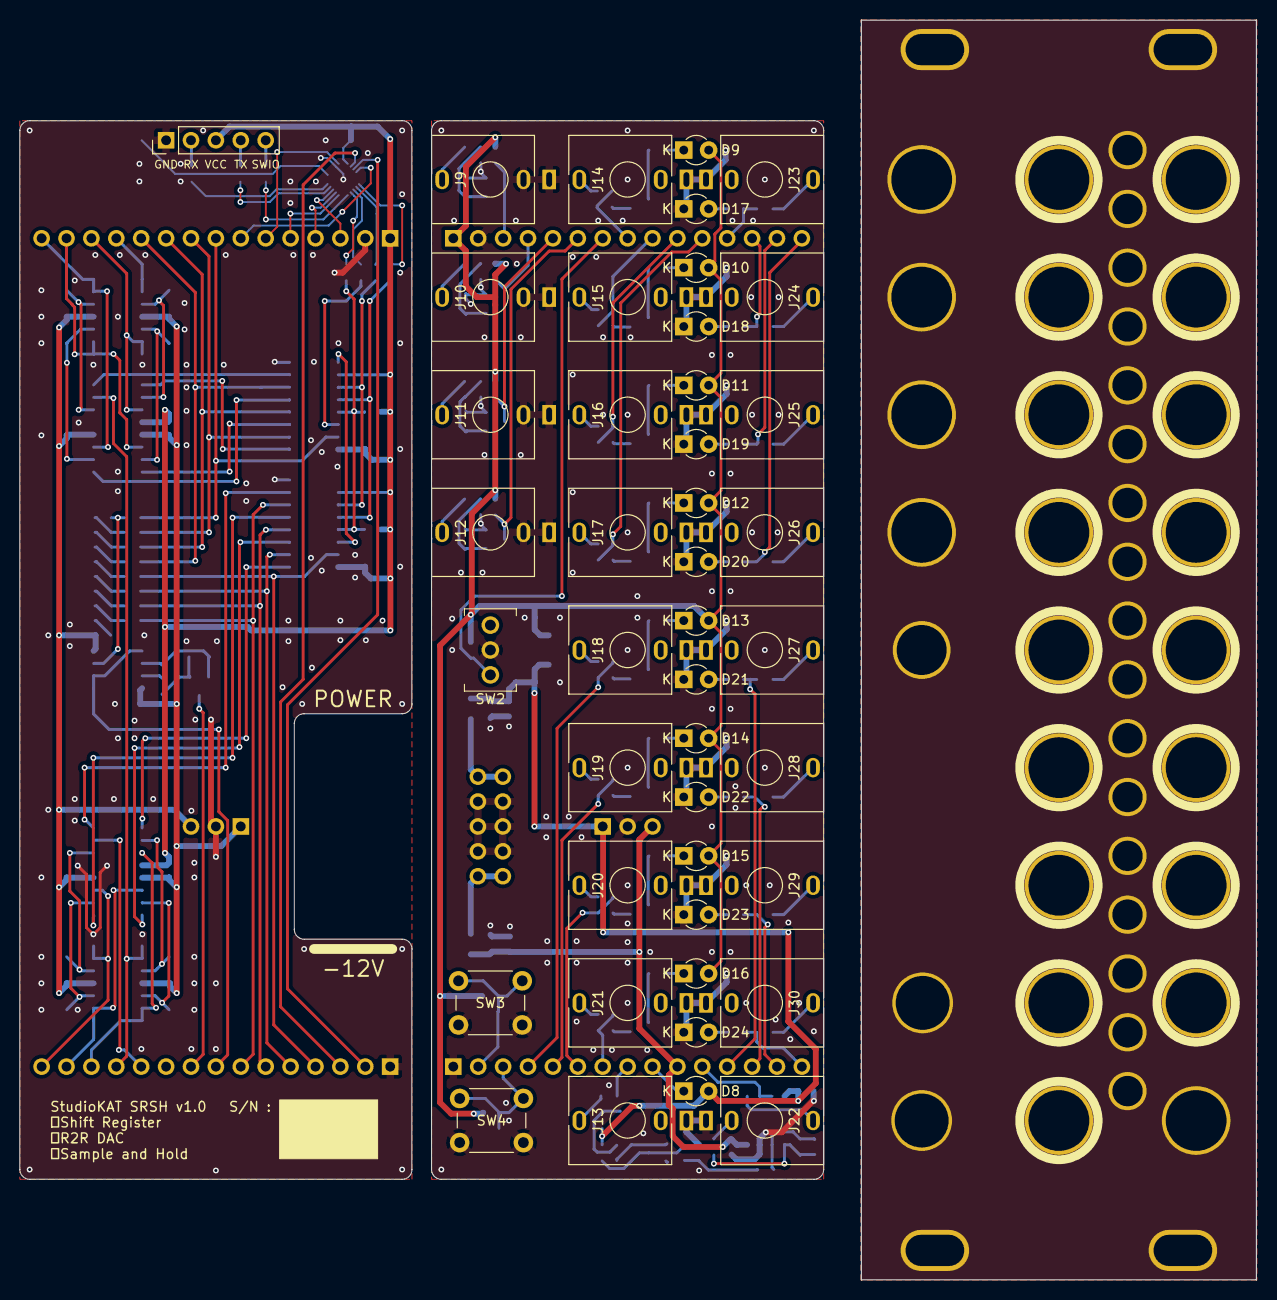
[picture p8: board SRSH_v1.0.kicad_pcb from above]

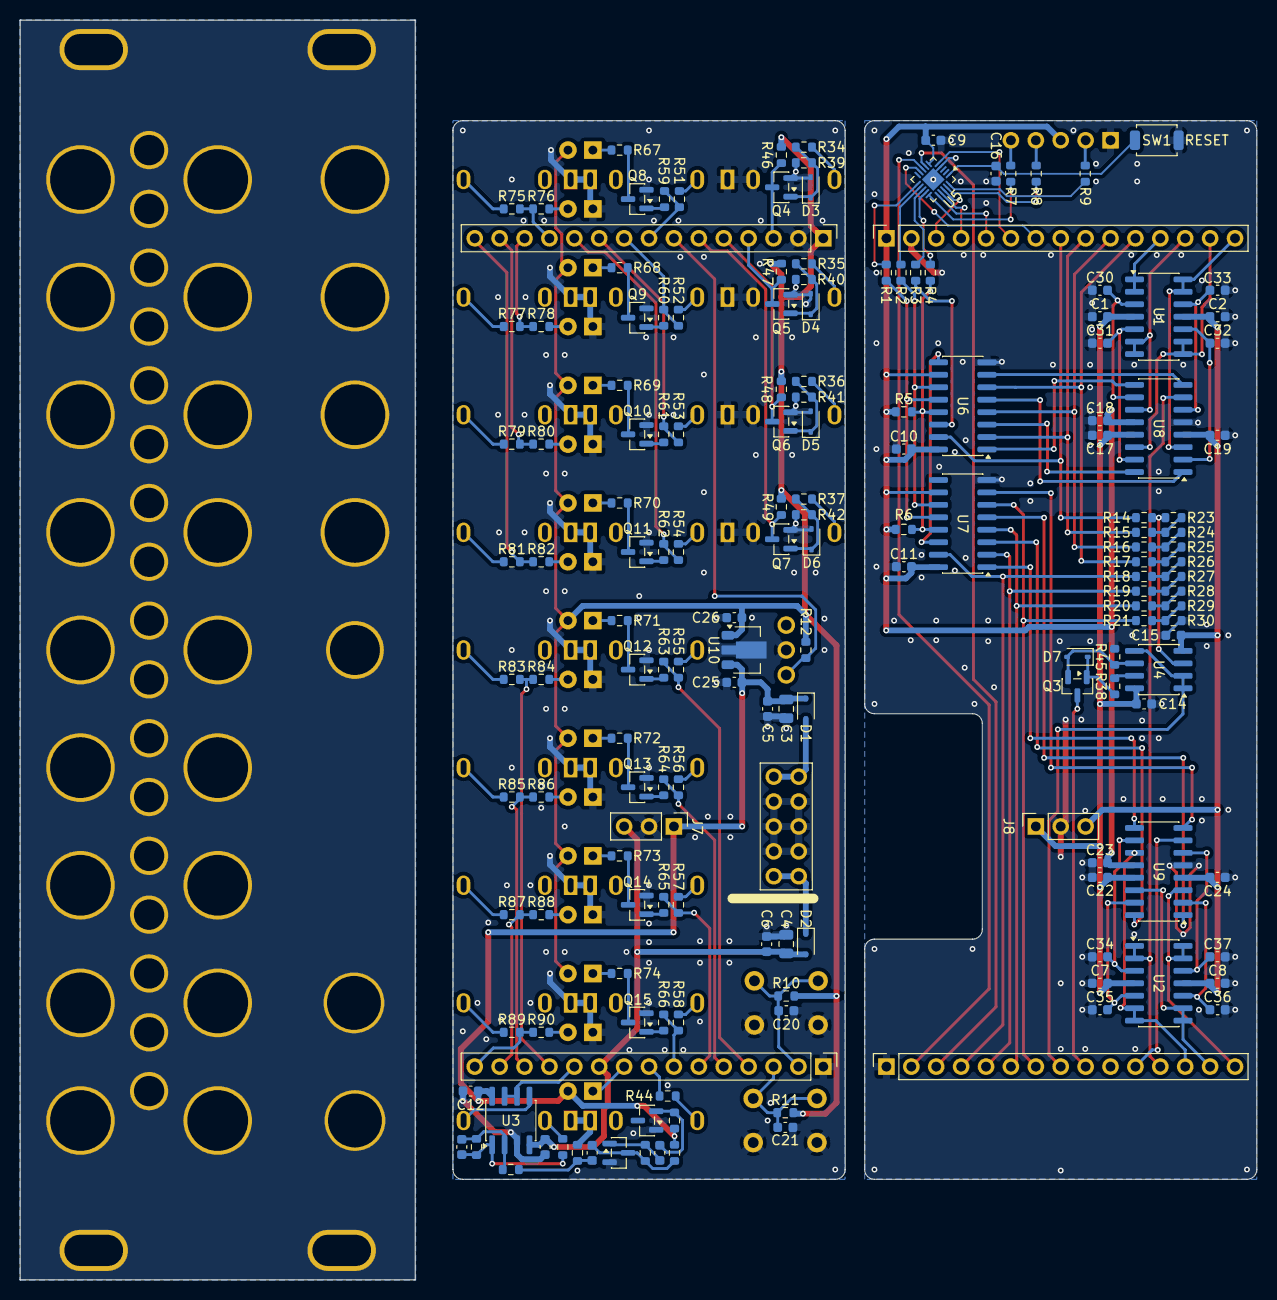
[picture p9: board SRSH_v1.0.kicad_pcb from below]

Board: 2 copper layers, 126.2 x 128.5 mm, 253 parts (167 on the bottom side), 171 nets.
